NiallEd-GH/Disk-Demon-2026-Rework/Original 1987 Disk Demon/Photos/Solderside_IMG_3149.JPG

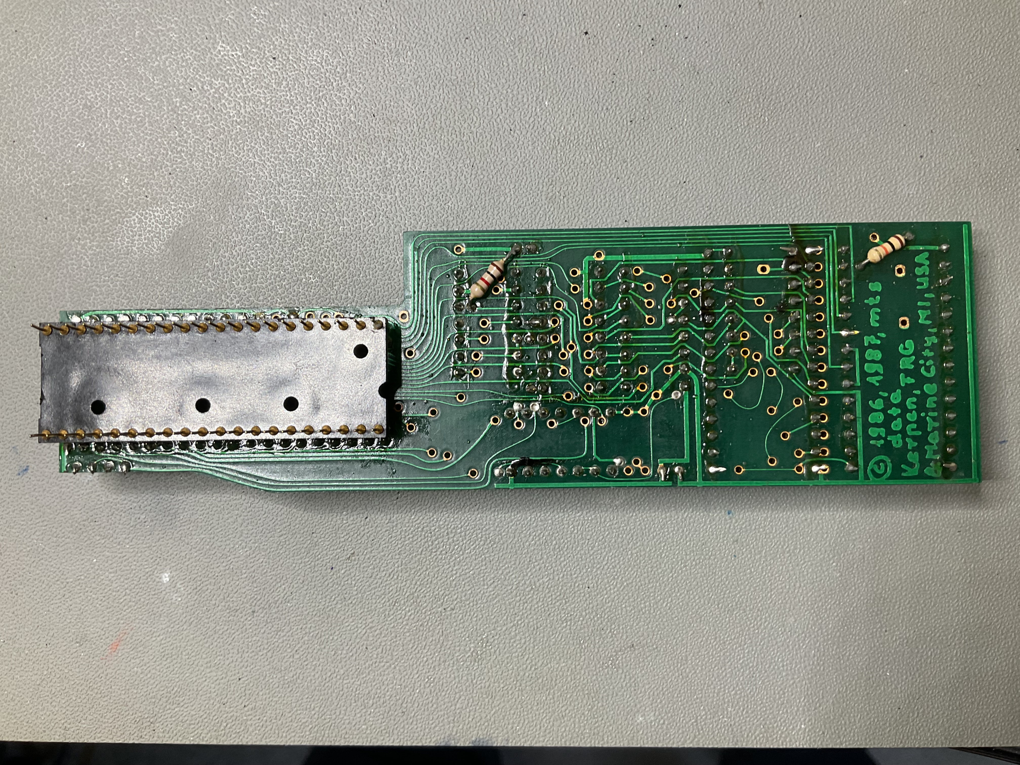
Original 1987 Disk Demon/Photos/Solderside_IMG_3149.JPG
