NiallEd-GH/Disk-Demon-2026-Rework/Original 1987 Disk Demon/README.txt

Schematics, Manual & Photos for the original Disk Demon
