NiallEd-GH/Disk-Demon-2026-Rework/Original 1987 Disk Demon/Photos/README.txt

Various photos of original board and packaging
