NiallEd-GH/Disk-Demon-2026-Rework/Original 1987 Disk Demon/Photos/Advert2.pdf

·.
DI5"
D£"'''N

The Datel Disk Demon is an exciting new product for the 1541 owner!! If you own a 1541 you will know that although they are reliable in operation they are very slow. Fast load cartridges such as Diskmate
and the disk turbo on Action Replay, | can speed up the process | quite
considerably | with | load times down to as low as 10 seconds | for a
typical game program. | But this is about as fast as you can get with
the 1541 standard system because it has a serial data transfer. | This
means that all the data is transmitted down just two wires hence there is a limit to the speed.
The new DISK DEMON is a true parallel operating system for the 1541 and brings speed of loading and saving that were never dreamed of!! Just imagine a typical game of say 202 blocks LOADING IN 2.5 SECONDS. Disk Demon is easy to fit consisting of 2 main assemblies - one plugs inside the disk drive and the other inside the 64/128. Usually no soldering is required. Now plug the parallel cable into the user port of the 64/128 And thats it. You then have the fastest disk
operating system available anywhere, at any price for the 1541.
Just look at the features; *
LOADS AT 60 TIMES NORMAL SPEED | program files)(202blocks 2.5 secs) *
LOADS AT 20 TIMES NORMAL SPEED | seq files) *
SAVES AT 25 TIMES NORMAL SPEED | prg files) ( 202 blocks 8 secs)
*
SAVES AT ~O TIMES NORMAL SPEED | seq files)
Disk Demon is not only a superfast system. | It also features a brand
new set of disk commands that do all the things that it should have done to start with ... plus many more. *
16 | FUNCTION | KEYS. | including | LIST ,SAVE, LOAD, RUN,
DIRECTORY,OLD,VERIFY,FAST FORMAT,GOODBYE etc. etc.
*
FORMAT DISKS UPTO 749 BLOCKS.

*
LOCK/ UNLOCK FILES.
*
UNIQUE FLOAD COMMAND . WILL LOAD FILES UPTO 250 BLOCKS.
NB. Other systems such as Dolphins Dos can't cope with files of over 202 blocks. This makes D.Demon super-powerful when used with Action Replay III. ie. An AR3 backup wi11 reload in UNDER 3 SECS!!
* | BUILT | IN FILE COPIER. Will uopy files UPTO 250 BLOCKS | at the
press of a function key. Super fast - complete | process | takes
about 15 seconds including the save.
*
User port through bus is supplied free to allow other devices be connected at the same time. (with Dolphin you pay 14.99 just this bit.)
| | | | to for

*
A HOST OF OTHER NEW COMMANDS including Number | conversion,Unstopable
reset, | ON/OFF etc etc. Plus all other disk operations | including
Scratch, Verify etc are also speeded up to a similar degree.
*
DISK DEMON is highly compatible with commercial software. On the odd occasion where there is a problem it is switched out at the flick of a switch. The system will then return to the original DOS.
***
~'¥henyou compare parallel systems remember that Disk Demon not only has more features the others. .. it also works at at least TWICE THE
SPEED of any other currently available. | So don't sit waiting | for
that disk to load .. ORDER DISK DEMON NOW!!!!!!

DISK DEMON COSTS 64.99 post free.A Utility disk is available with 15 second
disk copier,superfast selective file copier and file splitter. | price | is
7.99 or 4.99 when bought with Disk Demon.
* TIMINGS | DO NOT INCLUDE | SEARCHTIME
