NiallEd-GH/Disk-Demon-2026-Rework/Original 1987 Disk Demon/Photos/All_Chips_Top_IMG_3147-L.JPG

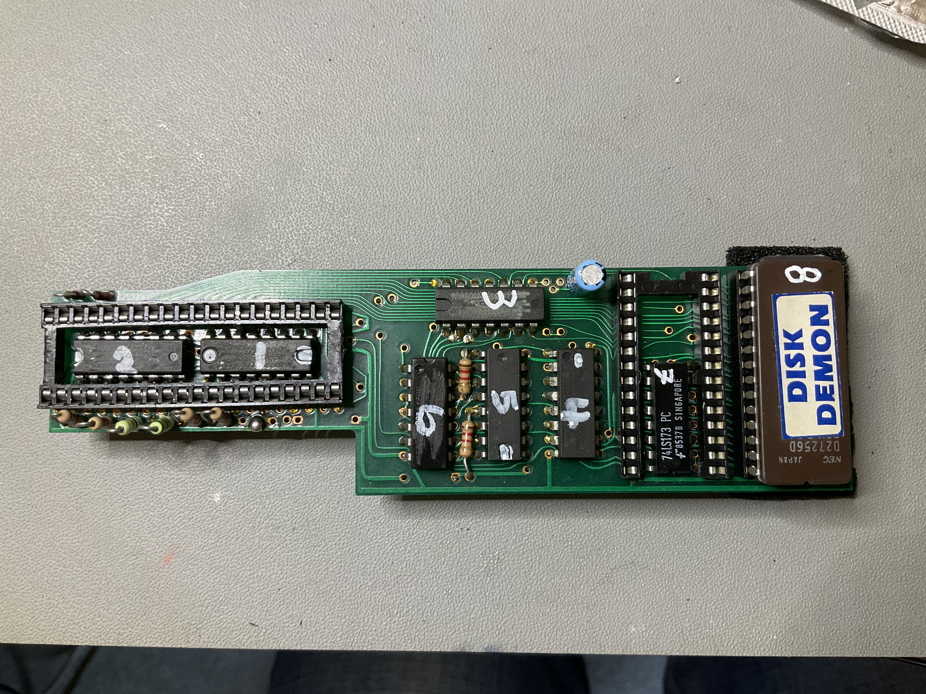
Original 1987 Disk Demon/Photos/All_Chips_Top_IMG_3147-L.JPG
