NiallEd-GH/Disk-Demon-2026-Rework/Original 1987 Disk Demon/Photos/box2.jpeg

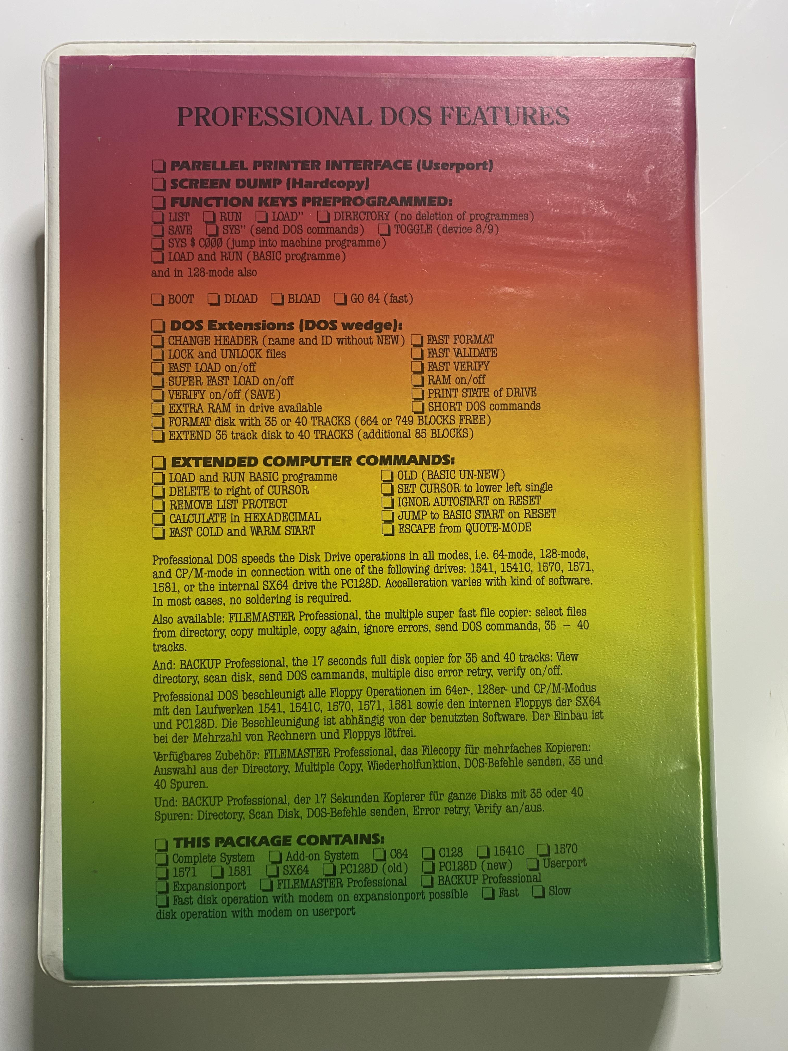
Original 1987 Disk Demon/Photos/box2.jpeg
