NiallEd-GH/Disk-Demon-2026-Rework/Original 1987 Disk Demon/Photos/Collection-C.jpeg

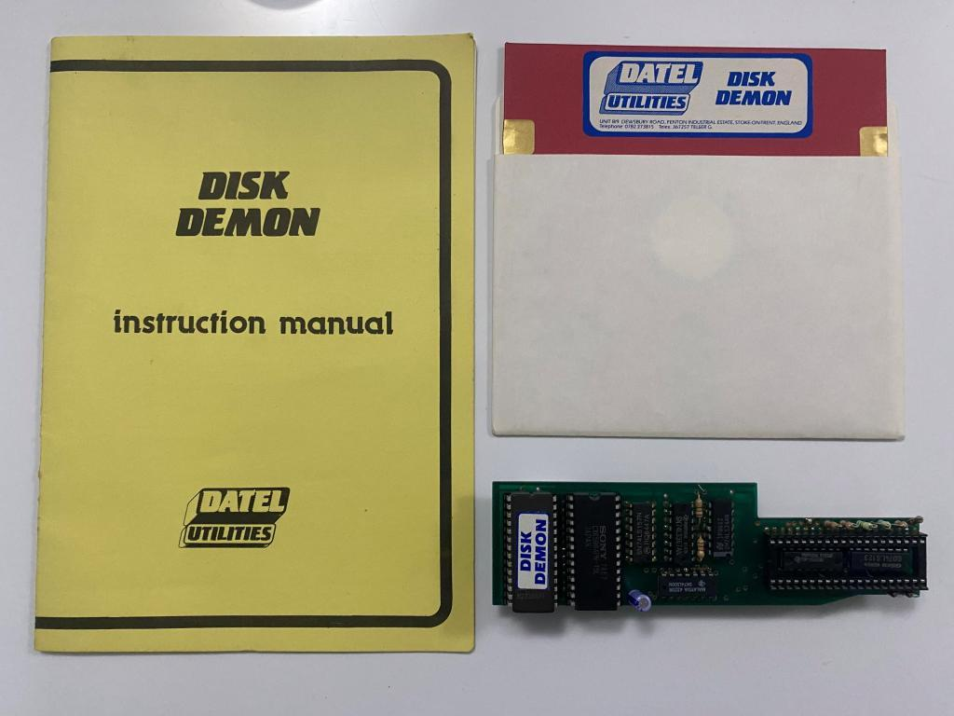
Original 1987 Disk Demon/Photos/Collection-C.jpeg
