NiallEd-GH/Disk-Demon-2026-Rework/Original 1987 Disk Demon/Photos/image5.jpeg

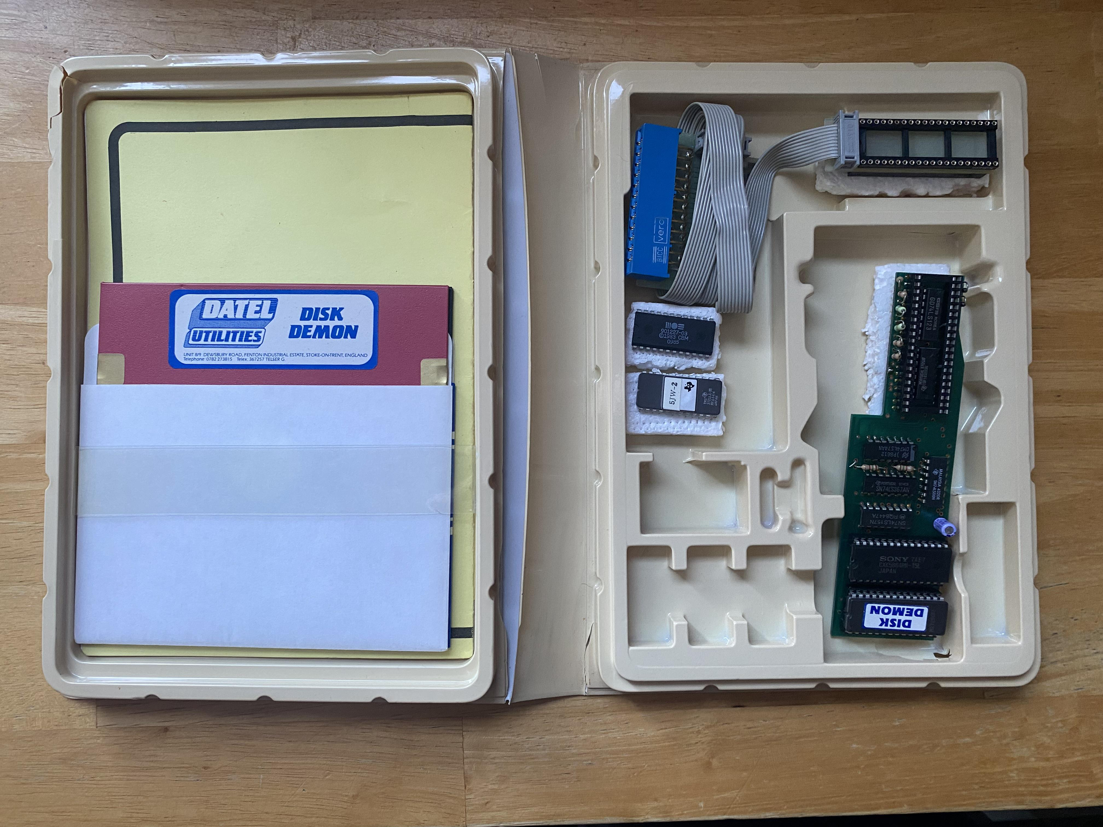
Original 1987 Disk Demon/Photos/image5.jpeg
