NiallEd-GH/Disk-Demon-2026-Rework/PCB Rev 4/BOM_Disk Demon_2026_Rework_Rev4.xlsx

Bill of Materials |  | Disk Demon 2026 Rework |  | Rev 4
Last update |  | 2026-09-13
Designator | Qty | Value | Footprint |  | Type | Description | KiLib_Generator
C1, C2 ** | 2 | 100pF | R_Axial_DIN0207_L6.3mm_D2.5mm_P2.54mm_Vertical |  | tht | Capacitor, 16v, +/-5% preferred. If Radial use 2.5mm lead spacing | capacitor/THT/other
C3 | 1 | 10 uF | CP_Radial_D4.0mm_P1.50mm |  | tht | Electrolytic capacitor, 16v, Radial. Note narrow lead spacing | capacitor/THT/other
C4, C5, C6, C7 | 2 | 100nF | C_Disc_D4.7mm_W2.5mm_P5.00mm |  | tht | Ceramic capacitor, 16v, +/-20%, Radial | capacitor/THT/other
D1 | 1 | 1N4148 | D_DO-35_SOD27_P7.62mm_Horizontal |  | tht | 100V 0.15A standard switching diode, DO-35, Axial | diode/THT
D2 | 1 | 1N4148 | D_DO-35_SOD27_P7.62mm_Horizontal |  | tht | 100V 0.15A standard switching diode, DO-35, Axial | diode/THT
R1, R2 ** | 2 | 5K6 | R_Axial_DIN0207_L6.3mm_D2.5mm_P2.54mm_Vertical |  | tht | Resistor, +/-1% 0.25w, Vertical mount, Axial | resistor/THT
R3.R4 | 0 | n/a | n/a |  |  | Not used | n/a
R5 | 1 | 1K8 | R_Axial_DIN0204_L3.6mm_D1.6mm_P5.08mm_Horizontal |  | tht | Resistor, +/-10% 0.25w, Horizontal mount, Axial | resistor/THT
R6 | 1 | 1K8 | R_Axial_DIN0204_L3.6mm_D1.6mm_P5.08mm_Horizontal |  | tht | Resistor, +/-10% 0.25w, Horizontal mount, Axial | resistor/THT
R7 | 1 | 1K0 | R_Axial_DIN0204_L3.6mm_D1.6mm_P5.08mm_Horizontal |  | tht | Resistor, +/-10% 0.25w, Horizontal mount, Axial | resistor/THT
R8 | 1 | 10K | R_Axial_DIN0204_L3.6mm_D1.6mm_P5.08mm_Horizontal |  | tht | Resistor, +/-10% 0.25w, Horizontal mount, Axial | resistor/THT
U1 | 1 | ATF16V8B-15PU | DIP-20_W7.62mm |  | tht | High-performance EE PLD, PAL Device Emulation / PAL Replacement | package/DIP/legacy
U2 | 1 | 74LS123 | DIP-16_W7.62mm |  | tht | Dual retriggerable Monostable | package/DIP/legacy
U3 | 1 | 74LS00 | DIP-14_W7.62mm |  | tht | Quad 2-input NAND gate | package/DIP/legacy
U4 | 1 | 74LS157 | DIP-16_W7.62mm |  | tht | Quad 2 to 1 line Multiplexer | package/DIP/legacy
U5 | 1 | 74LS367 | DIP-16_W7.62mm |  | tht | Hex Bus Driver 3-state outputs | package/DIP/legacy
U6 | 1 | 74LS74 | DIP-14_W7.62mm |  | tht | Dual D Flip-flop, Set & Reset | package/DIP/legacy
U7 | 1 | 74LS173 | DIP-16_W7.62mm |  | tht | 4-bit D-type Register, 3 state out | package/DIP/legacy
U8 | 1 | 27C256/27256 | DIP-28_W15.24mm |  | tht | OneROM Fire 28 or EPROM 256 KiBit | package/DIP/legacy
U9 | 1 | HY6264AxP or TC5565 | DIP-28_W15.24mm |  | tht | 8Kx8 bit Static RAM, 100/120/150ns, DIP-28 | package/DIP/legacy
U10 | 1 | Socket (for 6502) | DIP-40_W15.24mm_Socket (SEE DESCRIPTION--->) |  | tht | Use 40 Machine pin DIL Socket or 2x 20 pin, 2.54mm, Single In Line FEMALE headers | package/DIP/legacy
X1 | 2 | Header (for 1541 6502 socket) | DIP-40_W15.24mm_Socket (SEE DESCRIPTION--->) |  | tht | Use 2x 20 pin, 2.54mm Turned Pin Single In Line MALE Header | package/DIP/legacy
n/a | 1 | Socket | DIP-28_W15.24mm_Socket for U8 |  | tht | 28 pin, 15.24mm (0.6 inch), DIL socket
n/a | 1 | Socket | DIP-28_W15.24mm_Socket for U9 (SEE DESCRIPTION--->) |  | tht | 28 pin, 15.24mm (0.6 inch), DIL socket
** | Alternate values for C1 & C2 and R1 & R2 are 56pF and 10K respectively
 | Original Disk Demon values were C1 & C2 =56pF, R1 & R2 = 9K4 (achieved by two resistors in series, values 1K2 & 8K2)
 | Original Professional DOS 2 values were C1 & C2 =56pF, R1 & R2 = 10K6 (achieved by two resistors in series, values 1K5 & 9K1)
Sources
 |  | UK |  | USA
ATF16V8B-15PU | U1 | Farnell UK (https://uk.farnell.com/) | https://uk.farnell.com/microchip/atf16v8b-15pu/spld-15ns-62mhz-dip-20/dp/3580676 | Mouser US |  | https://www.mouser.com/en/ProductDetail/Microchip-Technology/ATF16V8B-15PU?qs=2mdvTlUeTfCsdBIzx6v3gA%3D%3D
OneROM Fire 28 | U8 | https://onerom.org/ | https://shop.piers.rocks/product/one-rom/ | RetroHackShack US (https://www.retrohackshack.com/product/one-rom/?currency=USD)
Parallel Cable
For a ready made cable contact |  |  | Tim Harris at The Shareware Plus (https://sharewareplus.blogspot.com/) | sales@sharewareplus.com
Alternatively, to make your own
Parallel Cable User Port adaptor (https://github.com/FraEgg/commodore-1541-parallel-port-adapter-c64-c128-speeddos-dolphindos/tree/master/C64_UserP_Parallel_Adapter_2Bus) |  |  |  | PCBWay (https://www.pcbway.com/project/shareproject/C64_Userport_Adapter_Parallel_Cable_Set_for_the_Commodore_1541_Disk_Drive_Spe_3b86d1f8.html)
Parallel Cable 1541-6522 adaptor (https://github.com/FraEgg/commodore-1541-parallel-port-adapter-c64-c128-speeddos-dolphindos/tree/master/1541_Paralleladapter_VIA_6522(1541-1541C)) |  |  |  | PCBWay (https://www.pcbway.com/project/shareproject/1541_I_1541C_Parallel_Adapter_Parallel_Cable_Set_for_the_Commodore_1541_Disk_D_a27176a6.html)
10 Pin Ribbon Cable, 2.54mm Pitch, 2 Row, Female to Female, 50cm or 100cm |  |  |  | AliExpress (https://www.aliexpress.com/item/1005006806477584.html) |  | AliExpress (https://www.aliexpress.com/item/1005010457561349.html)
 | In some cases, the strain relief will need to be removed for the lid to fit correctly on the 1541
