NiallEd-GH/Disk-Demon-2026-Rework/Original 1987 Disk Demon/Manual/Manual_Front.jpeg

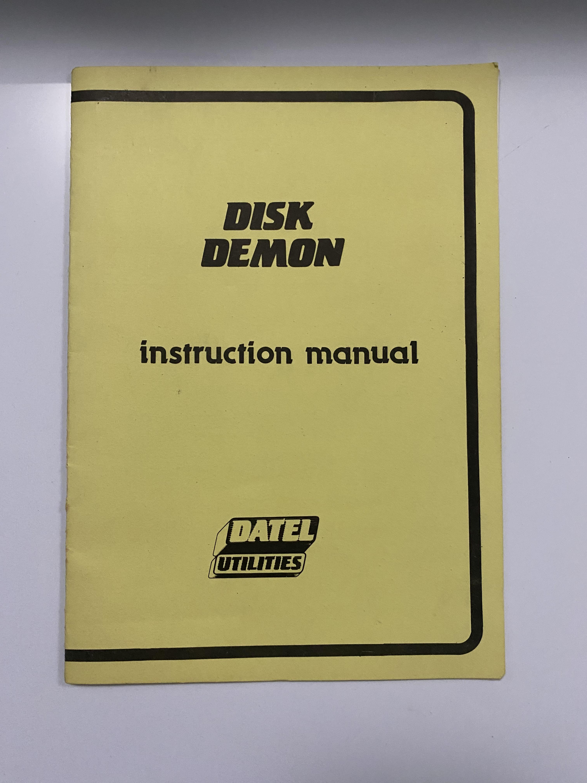
Original 1987 Disk Demon/Manual/Manual_Front.jpeg
