NiallEd-GH/Disk-Demon-2026-Rework/Original 1987 Disk Demon/Manual/Manual_Pg1.jpeg

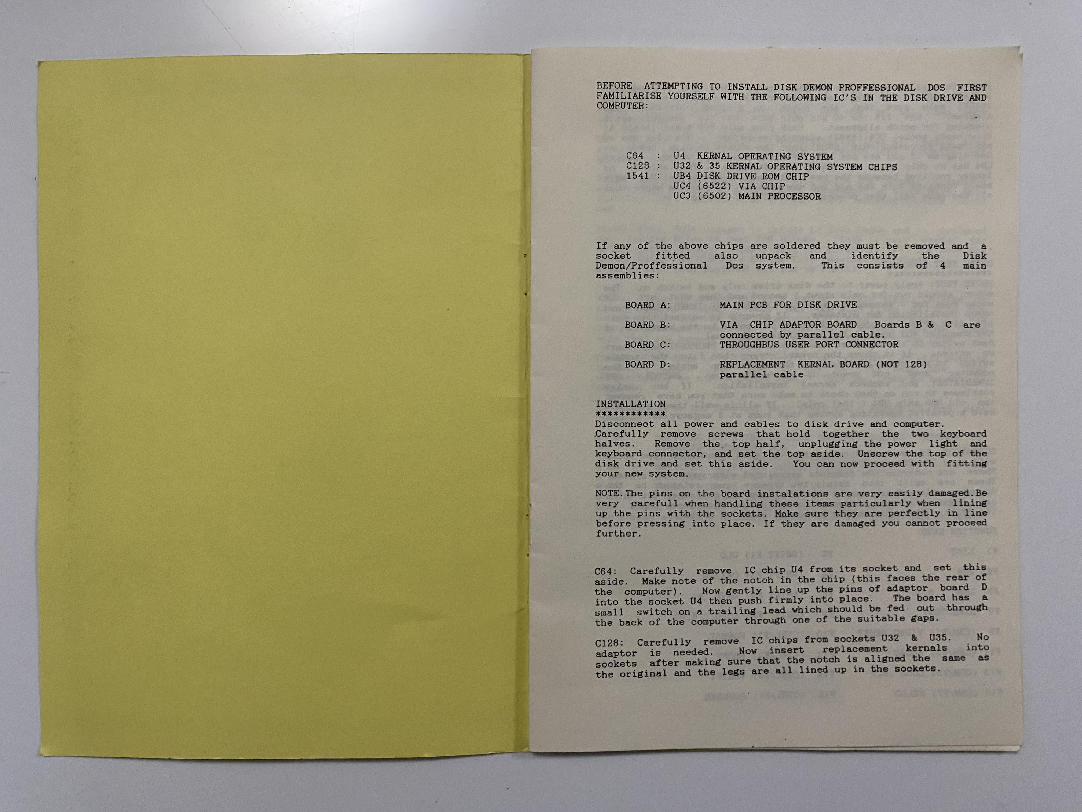
Original 1987 Disk Demon/Manual/Manual_Pg1.jpeg
