NiallEd-GH/Disk-Demon-2026-Rework/Original 1987 Disk Demon/Schematic_Disk-Demon_Original_1987_Version_Kicad-10.pdf

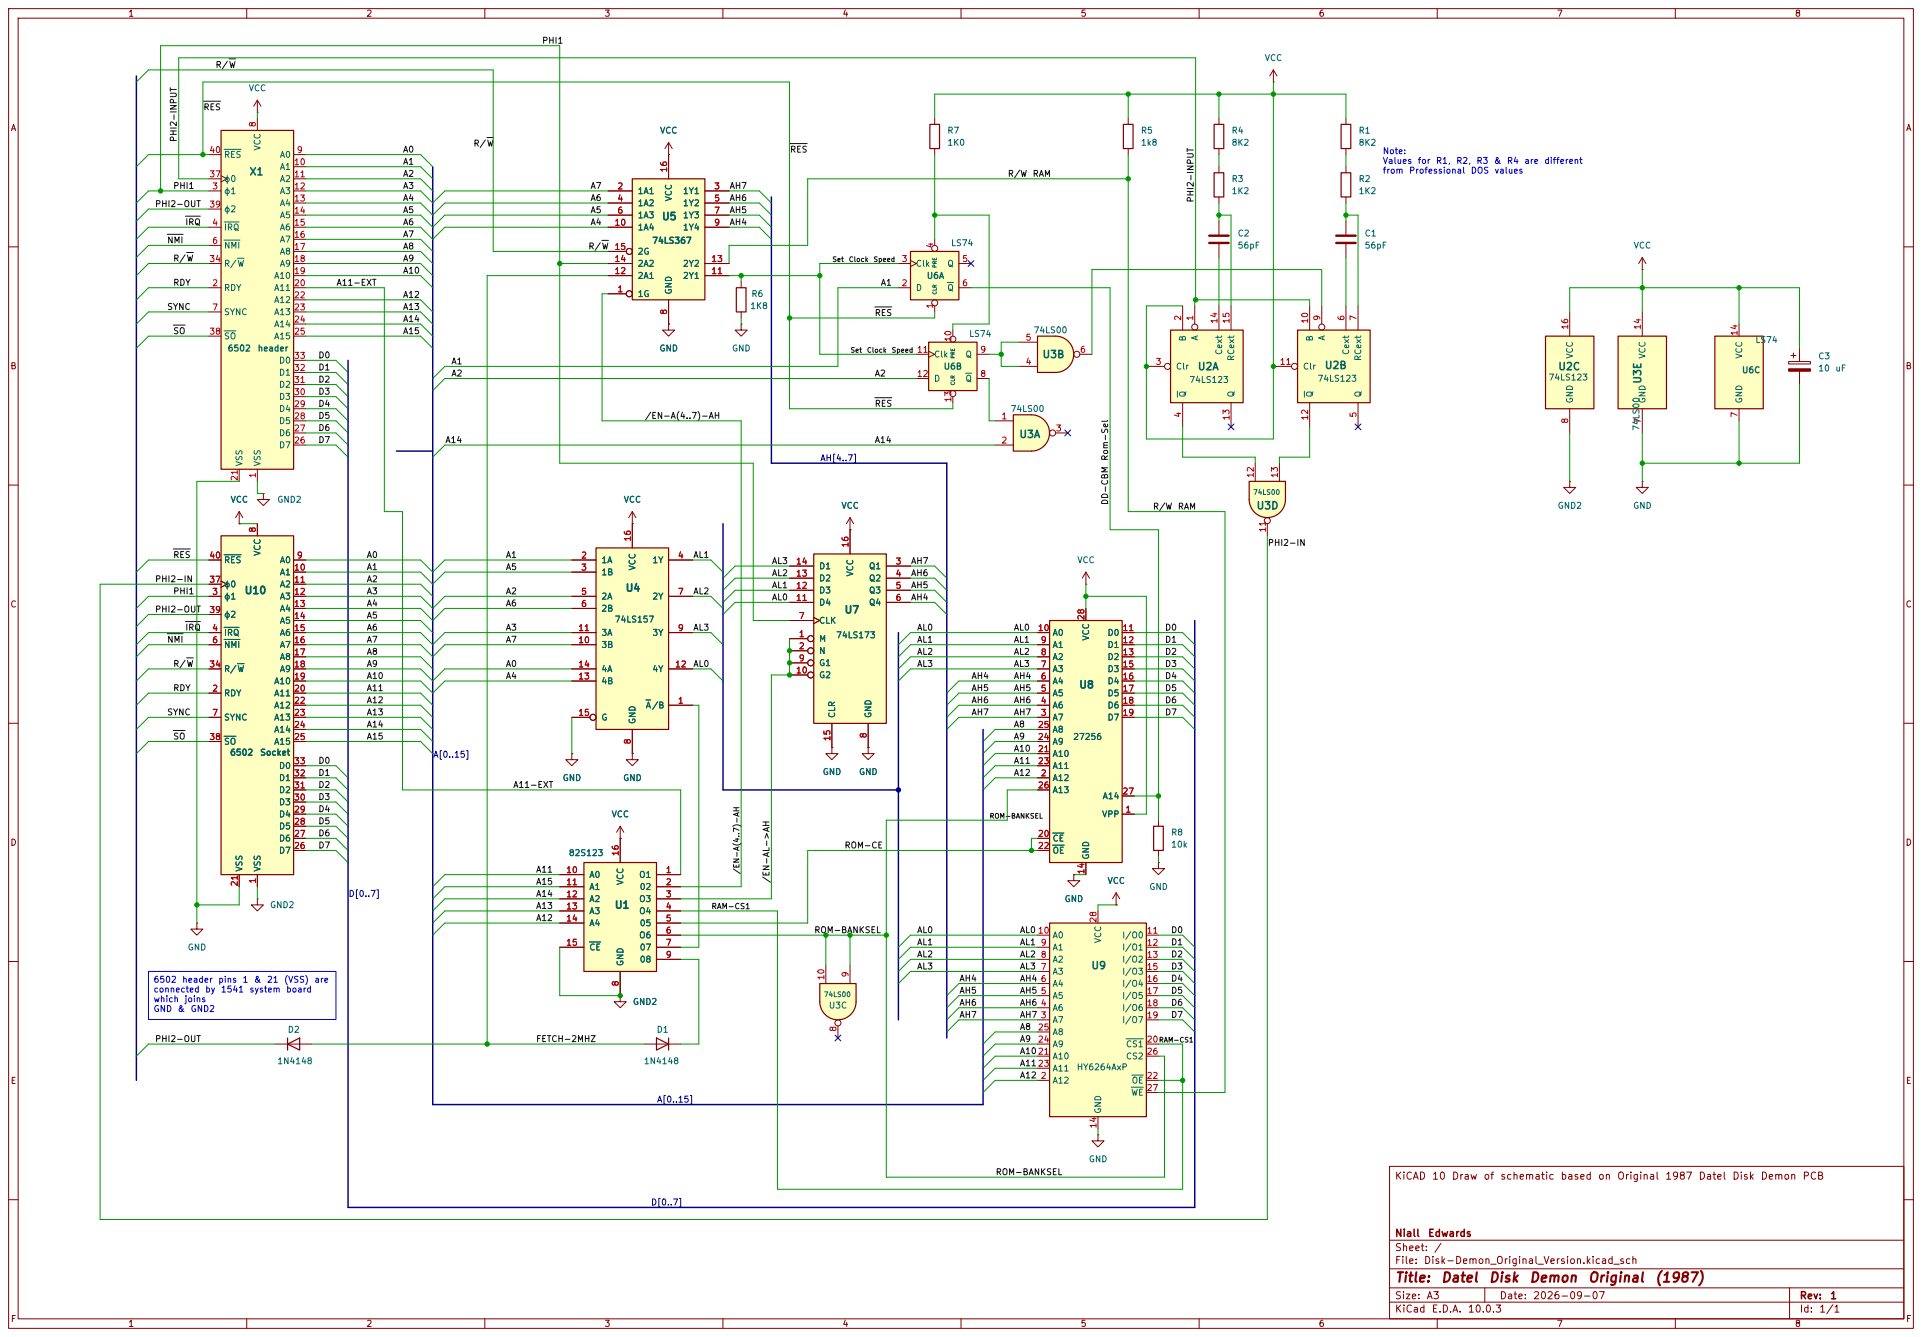
[picture p32: page 1]

Note: Values for R1, R2, R3 & R4 are different

from Professional DOS values GND U5

6502 header pins 1 & 21 (VSS) are
connected by 1541 system board which joins GND & GND2

KiCAD 10 Draw of schematic based on Original 1987 Datel Disk Demon PCB

Niall Edwards
Sheet: /
File: Disk-Demon_Original_Version.kicad_sch
Title: Datel Disk Demon Original (1987)

Size: A3 | Rev: 1
KiCad E.D.A. 10.0.3 | Id: 1/1 | F Date: 2026-09-07
