NiallEd-GH/Disk-Demon-2026-Rework/PCB Rev 4/Schematic_DD-Rework_Rev4.pdf

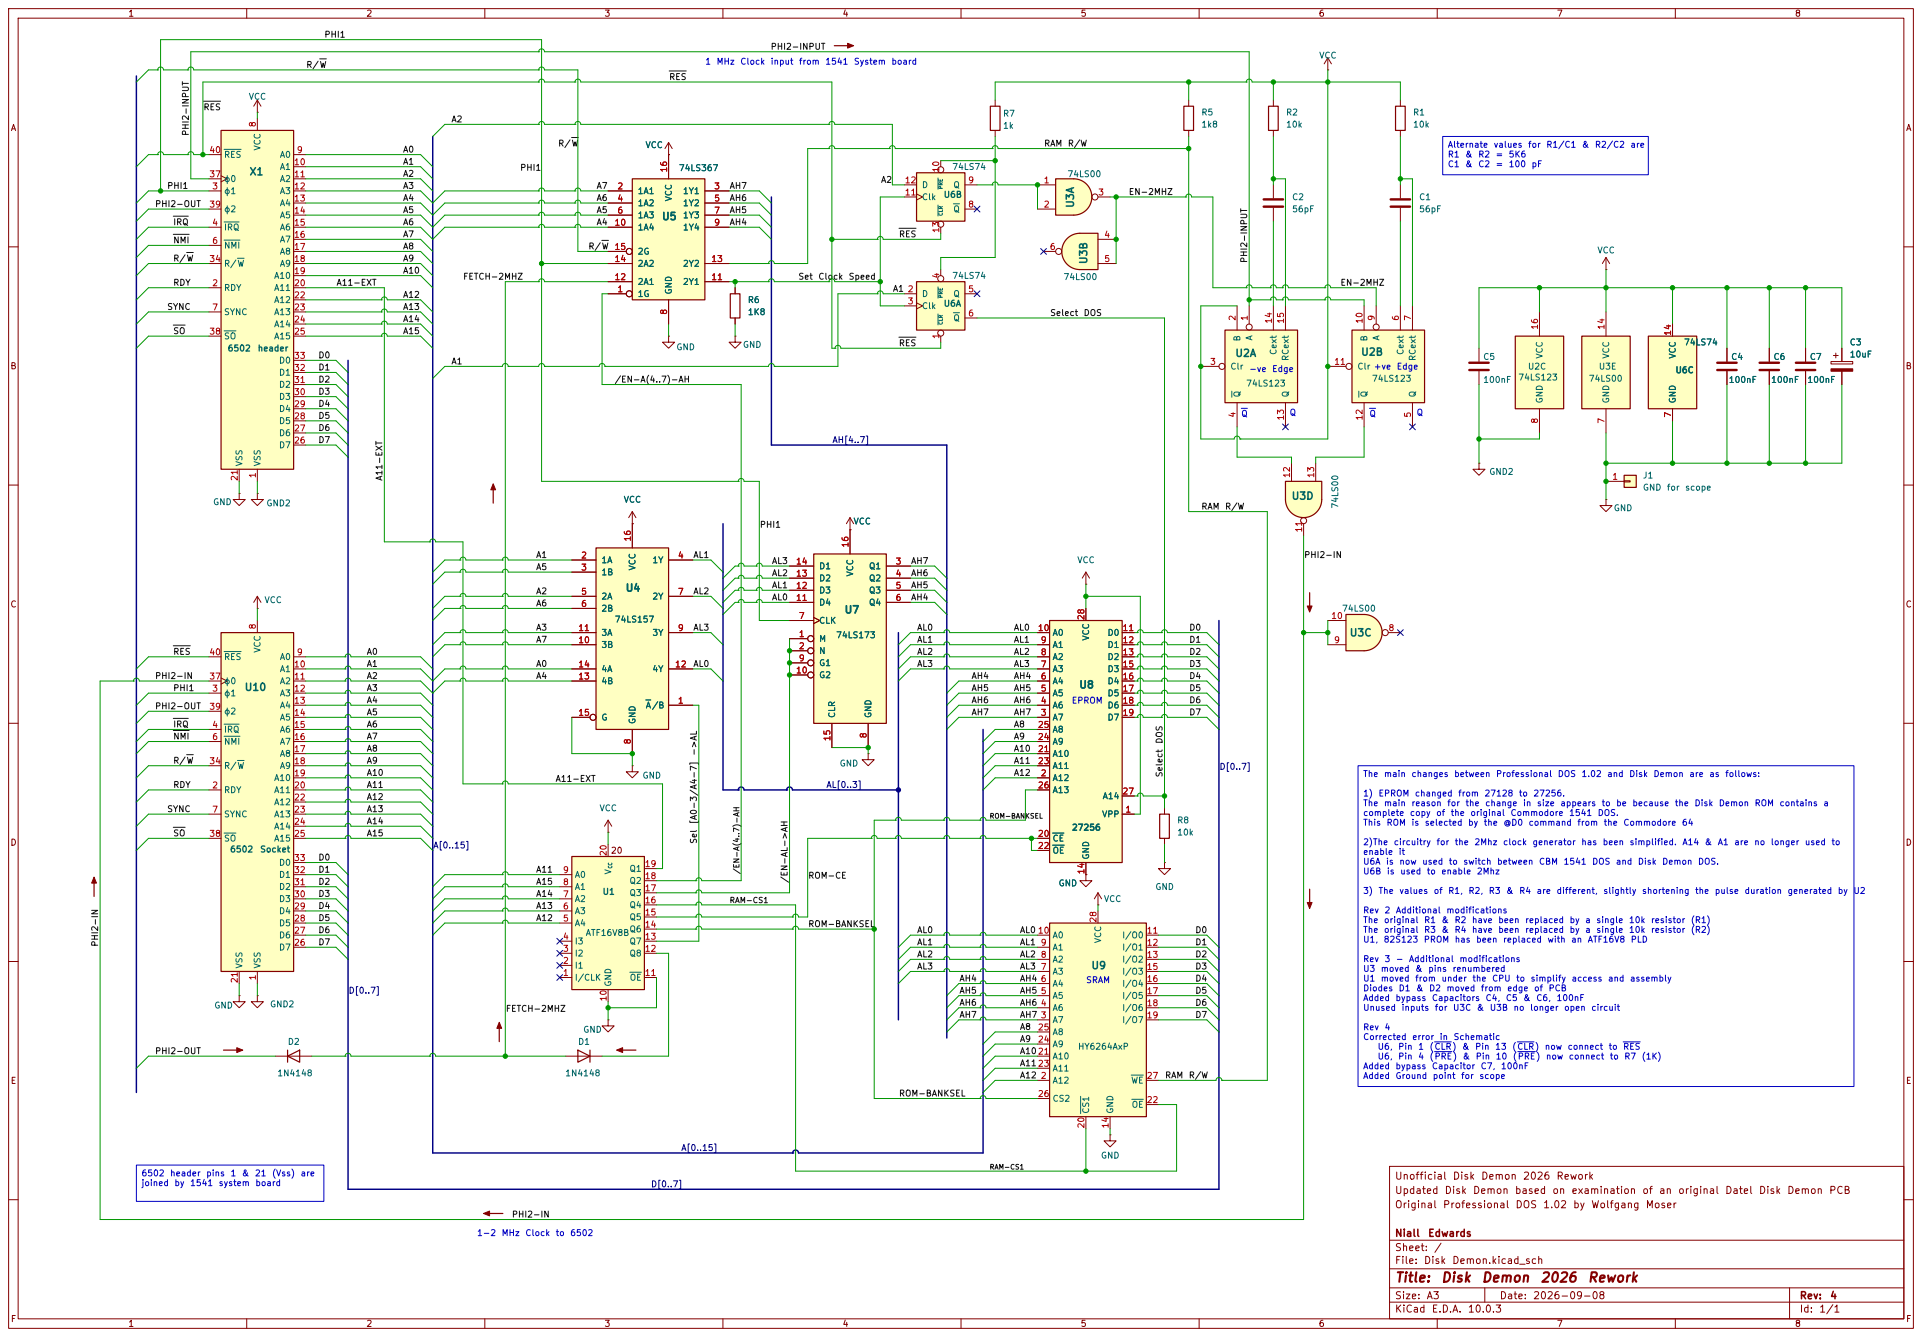
[picture p33: page 1]

Alternate values for R1/C1 & R2/C2 are R1 & R2 = 5K6 C1 & C2 = 100 pF

The main changes between Professional DOS 1.02 and Disk Demon are as follows: 1) EPROM changed from 27128 to 27256. The main reason for the change in size appears to be because the Disk Demon ROM contains a

complete copy of the original Commodore 1541 DOS. This ROM is selected by the @D0 command from the Commodore 64

2)The circuitry for the 2Mhz clock generator has been simplified. A14 & A1 are no longer used to

Unofficial Disk Demon 2026 Rework GNDGND 14 VCC 28

The original R1 & R2 have been replaced by a single 10k resistor (R1) The original R3 & R4 have been replaced by a single 10k resistor (R2)

U1, 82S123 PROM has been replaced with an ATF16V8 PLD

Rev 3 - Additional modifications U3 moved & pins renumbered U1 moved from under the CPU to simplify access and assembly Diodes D1 & D2 moved from edge of PCB

Added Ground point for scope SRAM

Added bypass Capacitors C4, C5 & C6, 100nF Unused inputs for U3C & U3B no longer open circuit Rev 4 Corrected error in Schematic U6, Pin 1 (CLR) & Pin 13 (CLR) now connect to RES U6, Pin 4 (PRE ) & Pin 10 (PRE ) now connect to R7 (1K) Added bypass Capacitor C7, 100nF

6502 header pins 1 & 21 (Vss) are
joined by 1541 system board

Updated Disk Demon based on examination of an original Datel Disk Demon PCB
Original Professional DOS 1.02 by Wolfgang Moser

Niall Edwards
Sheet: /
File: Disk Demon.kicad_sch
Title: Disk Demon 2026 Rework

Size: A3 | Rev: 4 | F Date: 2026-09-08
KiCad E.D.A. 10.0.3 | Id: 1/1
