NiallEd-GH/Disk-Demon-2026-Rework/PCB Rev 4/Disk Demon.kicad_pcb

## KiCad design PCB Rev 4/Disk Demon.kicad_pcb (2026-11-03)

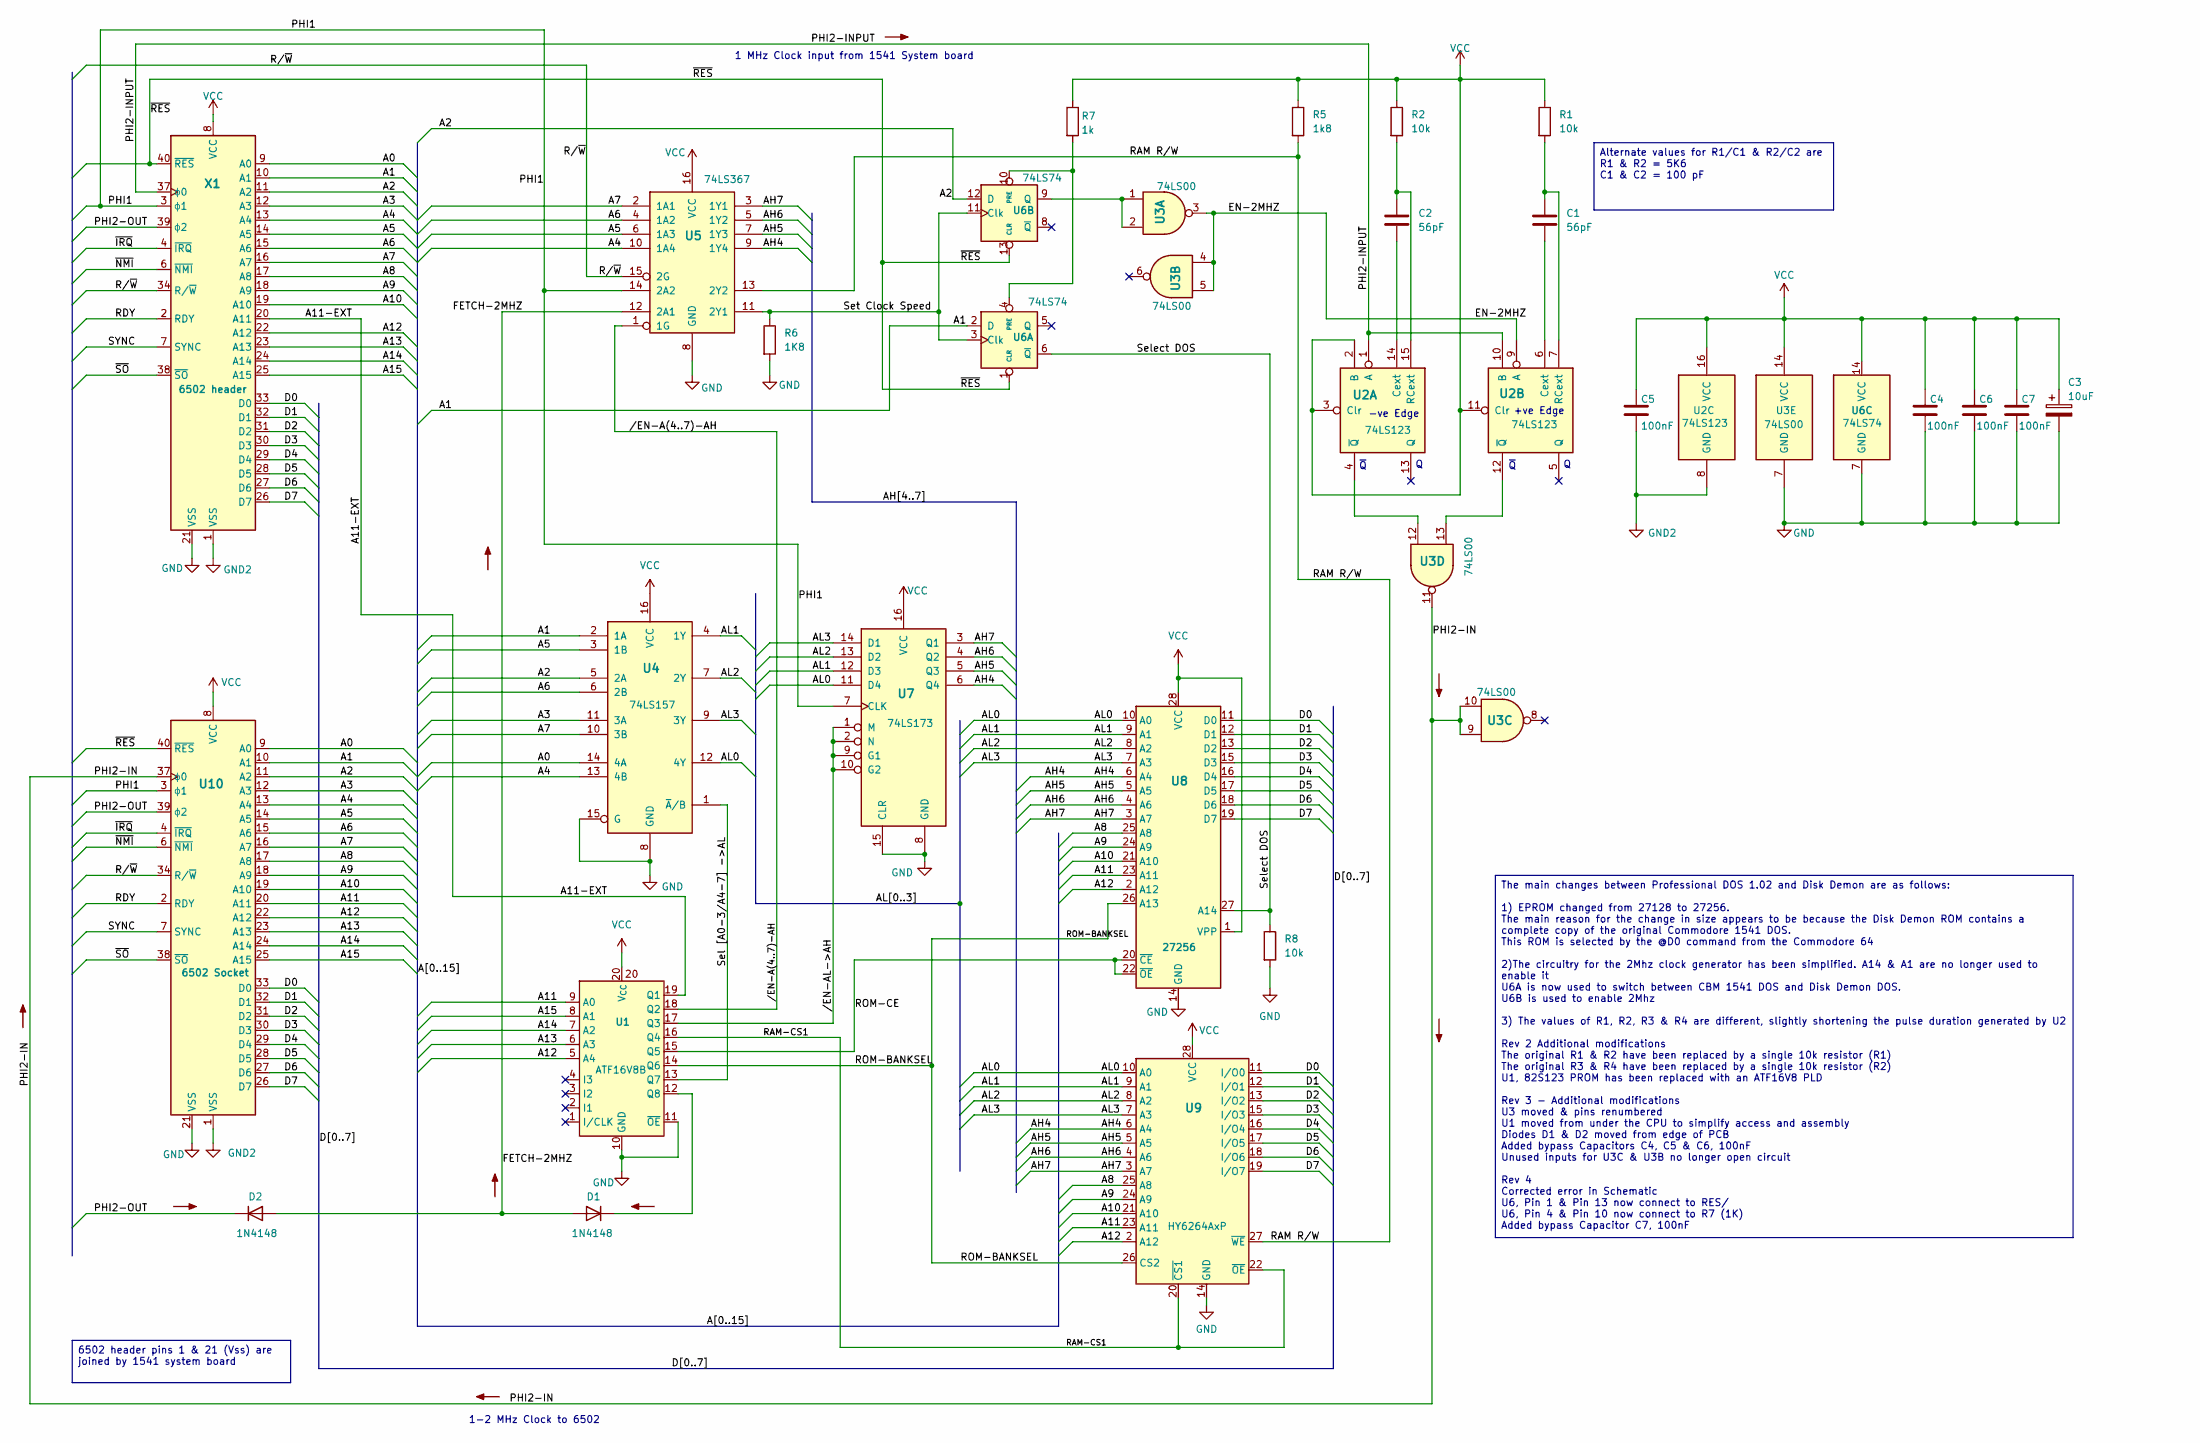
[picture p34: schematic Disk Demon.kicad_sch, Disk Demon 2026 Rework]

Parts:
C1, C2: 56pF; R_Axial_DIN0207_L6.3mm_D2.5mm_P2.54mm_Vertical
C3: 10uF; CP_Radial_D4.0mm_P1.50mm
C4, C5, C6, C7: 100nF; C_Disc_D4.7mm_W2.5mm_P5.00mm
D1, D2: 1N4148; D_DO-35_SOD27_P7.62mm_Horizontal
R1, R2: 10k; R_Axial_DIN0207_L6.3mm_D2.5mm_P2.54mm_Vertical
R5: 1k8; R_Axial_DIN0207_L6.3mm_D2.5mm_P7.62mm_Horizontal
R6: 1K8; R_Axial_DIN0207_L6.3mm_D2.5mm_P7.62mm_Horizontal
R7: 1k; R_Axial_DIN0207_L6.3mm_D2.5mm_P7.62mm_Horizontal
R8: 10k; R_Axial_DIN0207_L6.3mm_D2.5mm_P7.62mm_Horizontal
U1: ATF16V8B; DIP-20_W7.62mm
U2: 74LS123; DIP-16_W7.62mm
U3: 74LS00; DIP-14_W7.62mm
U4: 74LS157; DIP-16_W7.62mm
U5: 74LS367; DIP-16_W7.62mm
U6: 74LS74; DIP-14_W7.62mm
U7: 74LS173; DIP-16_W7.62mm
U8: 27256; DIP-28_W15.24mm
U9: HY6264AxP; DIP-28_W15.24mm
U10: 6502 Socket; DIP-40_W15.24mm_Socket
X1: 6502 header; DIP-40_W15.24mm_Socket

Connections:
/A0: U4.14 (4A), U10.9 (A0), X1.9 (A0)
/A1: U4.2 (1A), U6.2 (D), U10.10 (A1), X1.10 (A1)
/A2: U4.5 (2A), U6.12 (D), U10.11 (A2), X1.11 (A2)
/A3: U4.11 (3A), U10.12 (A3), X1.12 (A3)
/A4: U4.13 (4B), U5.10 (1A4), U10.13 (A4), X1.13 (A4)
/A5: U4.3 (1B), U5.6 (1A3), U10.14 (A5), X1.14 (A5)
/A6: U4.6 (2B), U5.4 (1A2), U10.15 (A6), X1.15 (A6)
/A7: U4.10 (3B), U5.2 (1A1), U10.16 (A7), X1.16 (A7)
/A8: U8.25 (A8), U9.25 (A8), U10.17 (A8), X1.17 (A8)
/A9: U8.24 (A9), U9.24 (A9), U10.18 (A9), X1.18 (A9)
/A10: U8.21 (A10), U9.21 (A10), U10.19 (A10), X1.19 (A10)
/A11: U1.9 (A0), U8.23 (A11), U9.23 (A11), U10.20 (A11)
/A11-EXT: U1.19 (Q1), X1.20 (A11)
/A12: U1.5 (A4), U8.2 (A12), U9.2 (A12), U10.22 (A12), X1.22 (A12)
/A13: U1.6 (A3), U10.23 (A13), X1.23 (A13)
/A14: U1.7 (A2), U10.24 (A14), X1.24 (A14)
/A15: U1.8 (A1), U10.25 (A15), X1.25 (A15)
/AH4: U5.9 (1Y4), U7.6 (Q4), U8.6 (A4), U9.6 (A4)
/AH5: U5.7 (1Y3), U7.5 (Q3), U8.5 (A5), U9.5 (A5)
/AH6: U5.5 (1Y2), U7.4 (Q2), U8.4 (A6), U9.4 (A6)
/AH7: U5.3 (1Y1), U7.3 (Q1), U8.3 (A7), U9.3 (A7)
/AL0: U4.12 (4Y), U7.11 (D4), U8.10 (A0), U9.10 (A0)
/AL1: U4.4 (1Y), U7.12 (D3), U8.9 (A1), U9.9 (A1)
/AL2: U4.7 (2Y), U7.13 (D2), U8.8 (A2), U9.8 (A2)
/AL3: U4.9 (3Y), U7.14 (D1), U8.7 (A3), U9.7 (A3)
/D0: U8.11 (D0), U9.11 (I/O0), U10.33 (D0), X1.33 (D0)
/D1: U8.12 (D1), U9.12 (I/O1), U10.32 (D1), X1.32 (D1)
/D2: U8.13 (D2), U9.13 (I/O2), U10.31 (D2), X1.31 (D2)
/D3: U8.15 (D3), U9.15 (I/O3), U10.30 (D3), X1.30 (D3)
/D4: U8.16 (D4), U9.16 (I/O4), U10.29 (D4), X1.29 (D4)
/D5: U8.17 (D5), U9.17 (I/O5), U10.28 (D5), X1.28 (D5)
/D6: U8.18 (D6), U9.18 (I/O6), U10.27 (D6), X1.27 (D6)
/D7: U8.19 (D7), U9.19 (I/O7), U10.26 (D7), X1.26 (D7)
/EN-2MHZ: U2.9 (A), U3.3, U3.4, U3.5
/FETCH-2MHZ: D1.2 (A), D2.2 (A), U5.12 (2A1)
/PHI1: U5.14 (2A2), U7.7 (CLK), U10.3 (ϕ1), X1.3 (ϕ1)
/PHI2-IN: U3.9, U3.10, U3.11, U10.37 (ϕ0)
/PHI2-INPUT: U2.1 (A), U2.10 (B), X1.37 (ϕ0)
/PHI2-OUT: D2.1 (K), U10.39 (ϕ2), X1.39 (ϕ2)
/RAM R/W: R5.2, U5.13 (2Y2), U9.27 (~WE)
/RAM-CS1: U1.16 (Q4), U9.20 (~CS1), U9.22 (~OE)
/RDY: U10.2 (RDY), X1.2 (RDY)
/ROM-BANKSEL: U1.14 (Q6), U8.26 (A13), U9.26 (CS2)
/ROM-CE: U1.15 (Q5), U8.20 (~CE), U8.22 (~OE)
/R/~W: U5.15 (2G), U10.34 (R/~W), X1.34 (R/~W)
/SYNC: U10.7 (SYNC), X1.7 (SYNC)
/Sel [A0-3/A4-7] ->AL: U1.13 (Q7), U4.1 (~A/B)
/Select DOS: R8.1, U6.6 (~Q), U8.27 (A14)
/Set Clock Speed: R6.1, U5.11 (2Y1), U6.3 (Clk), U6.11 (Clk)
//EN-A(4..7)-AH: U1.18 (Q2), U5.1 (1G)
//EN-AL->AH: U1.17 (Q3), U7.1 (M), U7.2 (N), U7.9 (G1), U7.10 (G2)
/~IRQ: U10.4 (~IRQ), X1.4 (~IRQ)
/~NMI: U10.6 (~NMI), X1.6 (~NMI)
/~RES: U6.1 (CLR), U6.13 (CLR), U10.40 (~RES), X1.40 (~RES)
/~SO: U10.38 (~SO), X1.38 (~SO)
GND: C3.2, C4.2, C6.2, C7.2, R6.2, R8.2, U1.10 (GND), U1.11 (~OE), U3.7 (GND), U4.8 (GND), U4.15 (G), U5.8 (GND), U6.7 (GND), U7.8 (GND), U7.15 (CLR), U8.14 (GND), U9.14 (GND), U10.21 (VSS), X1.21 (VSS); also elsewhere on the board
GND2: C5.2, U2.8 (GND), U10.1 (VSS), X1.1 (VSS)
unnamed: D1.1 (K), U1.12 (Q8)
unnamed: C2.2, U2.14 (Cext)
unnamed: C2.1, R2.2, U2.15 (RCext)
unnamed: U2.4 (~Q), U3.12
unnamed: C1.2, U2.6 (Cext)
unnamed: C1.1, R1.2, U2.7 (RCext)
unnamed: U2.12 (~Q), U3.13
unnamed: R7.2, U6.4 (PRE), U6.10 (PRE)
unnamed: U3.1, U3.2, U6.9 (Q)
VCC: C3.1, C4.1, C5.1, C6.1, C7.1, R1.1, R2.1, R5.1, R7.1, U1.20 (V_{CC}), U2.2 (B), U2.3 (Clr), U2.11 (Clr), U2.16 (VCC), U3.14 (VCC), U4.16 (VCC), U5.16 (VCC), U6.14 (VCC), U7.16 (VCC), U8.1 (VPP), U8.28 (VCC), U9.28 (VCC), U10.8 (VCC), X1.8 (VCC)

Notes on the sheet:
1 MHz Clock input from 1541 System board
-ve Edge
1-2 MHz Clock to 6502
+ve Edge
~{Q}
Alternate values for R1/C1 & R2/C2 are R1 & R2 = 5K6 C1 & C2 = 100 pF
6502 header pins 1 & 21 (Vss) are joined by 1541 system board
The main changes between Professional DOS 1.02 and Disk Demon are as follows: 1) EPROM changed from 27128 to 27256. The main reason for the change in size appears to be because the Disk Demon ROM contains a complete copy of the original Commodore 1541 DOS. This ROM is selected by the @D0 command fr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

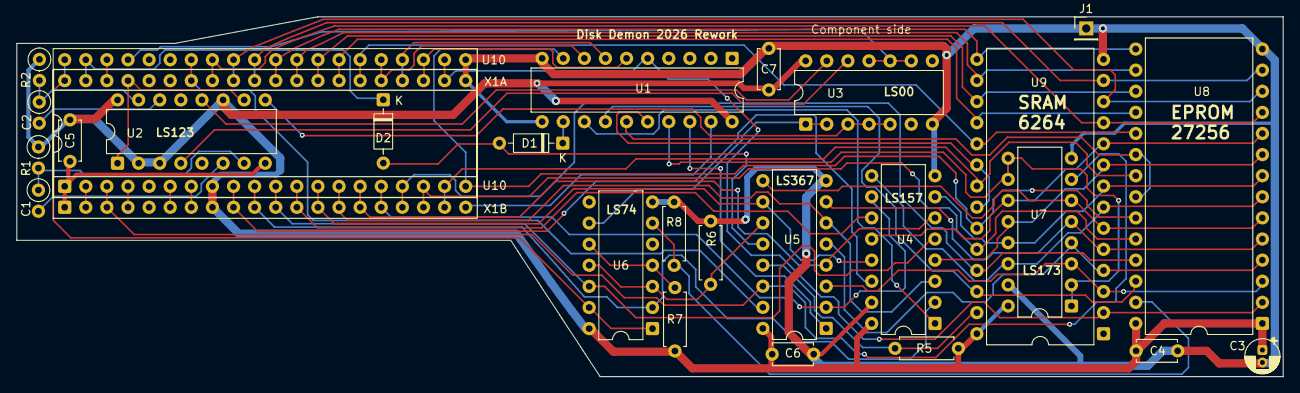
[picture p35: board Disk Demon.kicad_pcb from above]

Board: 2 copper layers, 152.4 x 43.3 mm, 27 parts (0 on the bottom side), 67 nets.

Other parts of the board:
J1: GND for scope; PinHeader_1x01_P2.54mm_Vertical

Their connections:
GND: J1.1 (Pin_1_1); also elsewhere on the board
