NiallEd-GH/Disk-Demon-2026-Rework/(commit log)

2026-11-03 Add readme file for PCB Rev 4
2026-11-03 Add schematic, manual, and photos for Disk Demon
2026-11-03 Add README with schematics and manual information
2026-11-03 Add README for photos of original board and packaging
2026-11-03 Add PCB project link for Disk Demon
    Added link to PCB project for Disk Demon on PCBWay.
